Krijf/KICAD_Library/README.md

# KICAD_Library
Personal Library for KICAD
