Krijf/KICAD_Library/Attribute.png

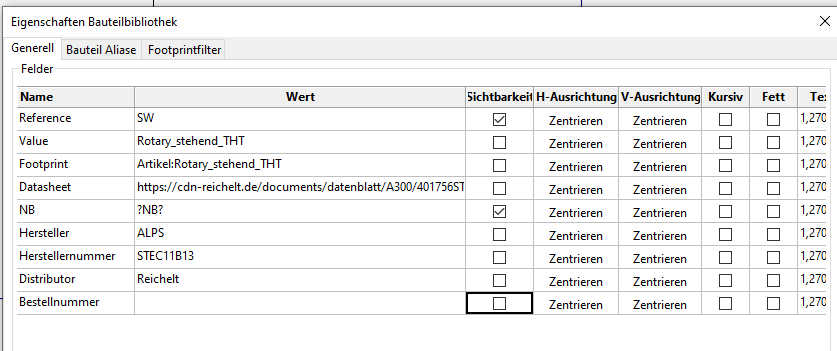
Attribute.png
