Krijf/KICAD_Library/3D_Models/PCB_Switch_Winkel_THT.step

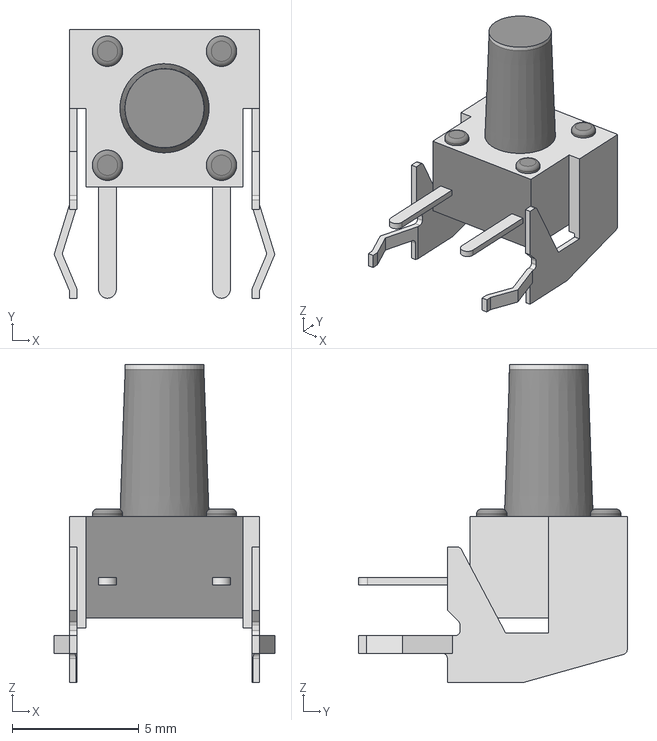
[picture p2: CAD file, 2020-07-17]
3D_Models/PCB_Switch_Winkel_THT.step
8.71 x 10.6 x 12.6 mm
