Krijf/KICAD_Library/3D_Models/USB_C_Buchse_SMD.stp

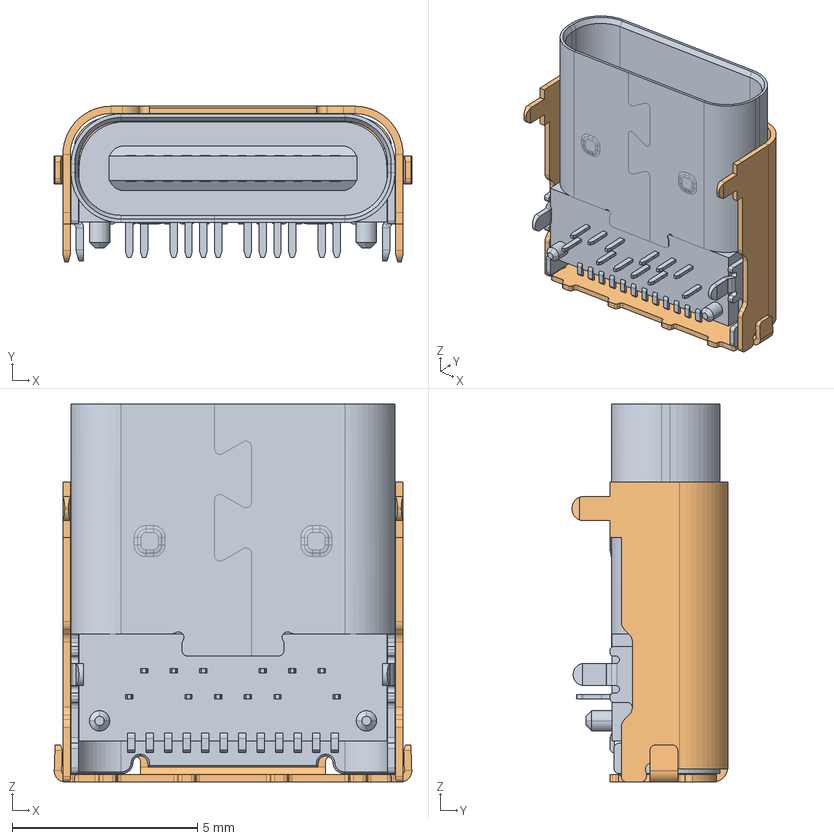
[picture p3: CAD file, 2020-07-17]
3D_Models/USB_C_Buchse_SMD.stp
9.65 x 4.20 x 10.2 mm
