Krijf/KICAD_Library/3D_Models/Rotary_stehend_THT.step

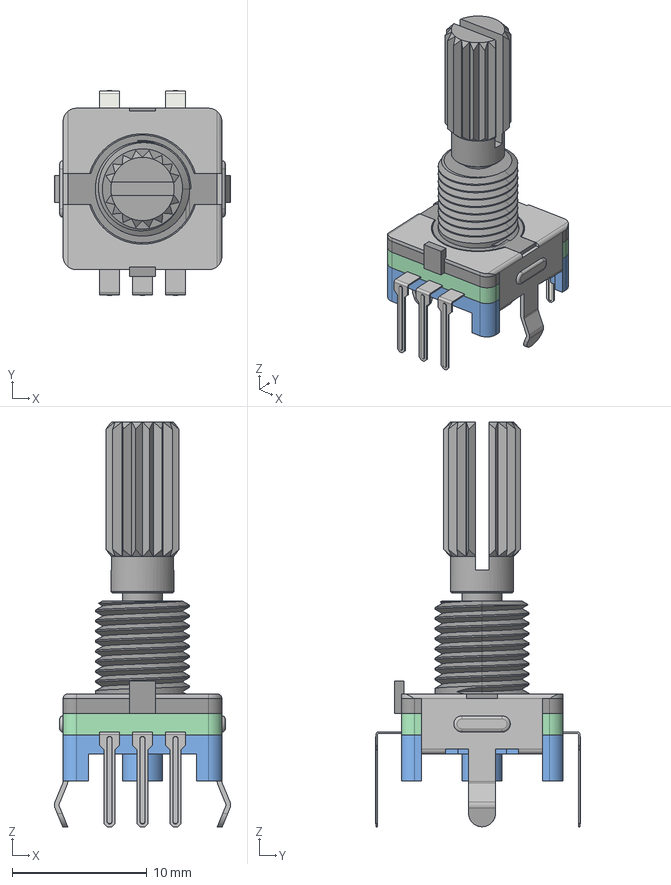
[picture p4: CAD file, 2020-07-16]
3D_Models/Rotary_stehend_THT.step
13.1 x 15.3 x 30.1 mm
