Krijf/KICAD_Library/3D_Models/Neopixel.step

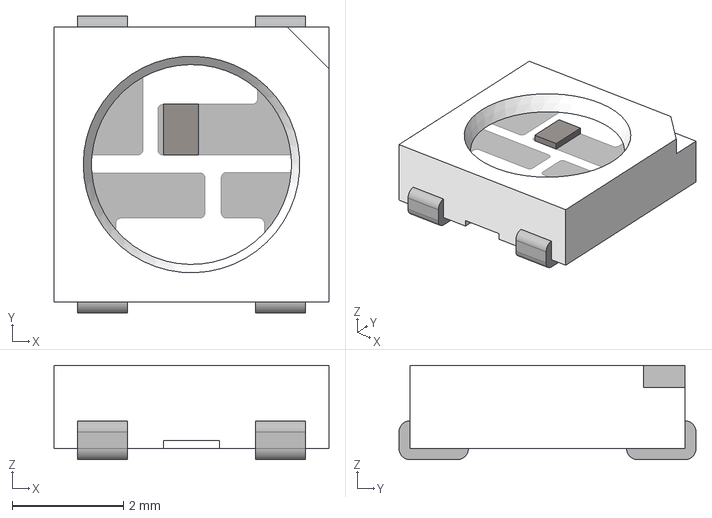
[picture p5: CAD file, 2020-07-16]
3D_Models/Neopixel.step
4.95 x 5.35 x 1.70 mm
