Krijf/KICAD_Library/3D_Models/RESC1608.step

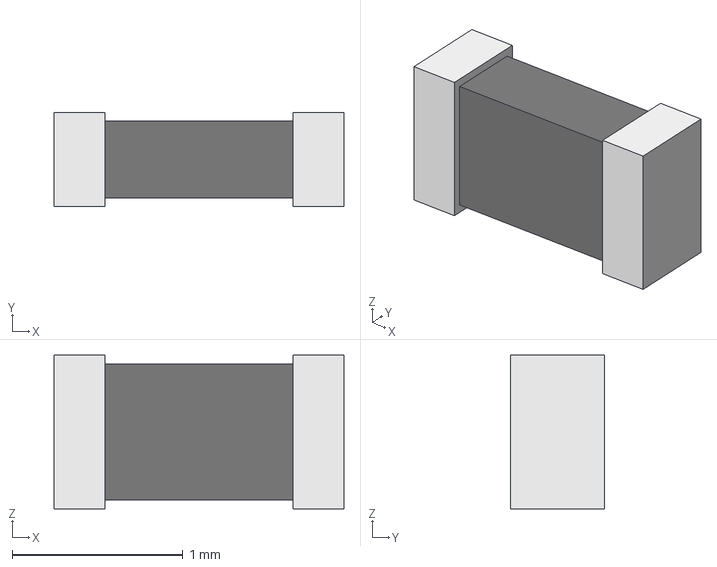
[picture p6: CAD file, 2020-07-06]
3D_Models/RESC1608.step
1.70 x 0.55 x 0.9 mm
