Krijf/KICAD_Library/3D_Models/CAPC3225.step

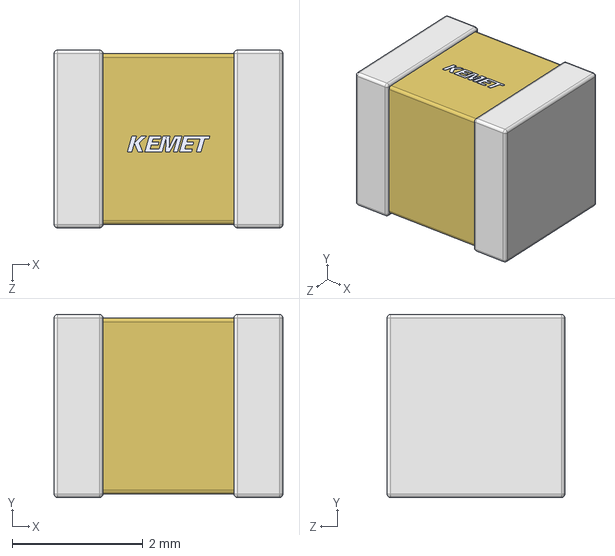
[picture p7: CAD file, 2020-07-06]
3D_Models/CAPC3225.step
3.50 x 2.80 x 2.72 mm
