Krijf/KICAD_Library/3D_Models/ATMEGA32U4-AU.step

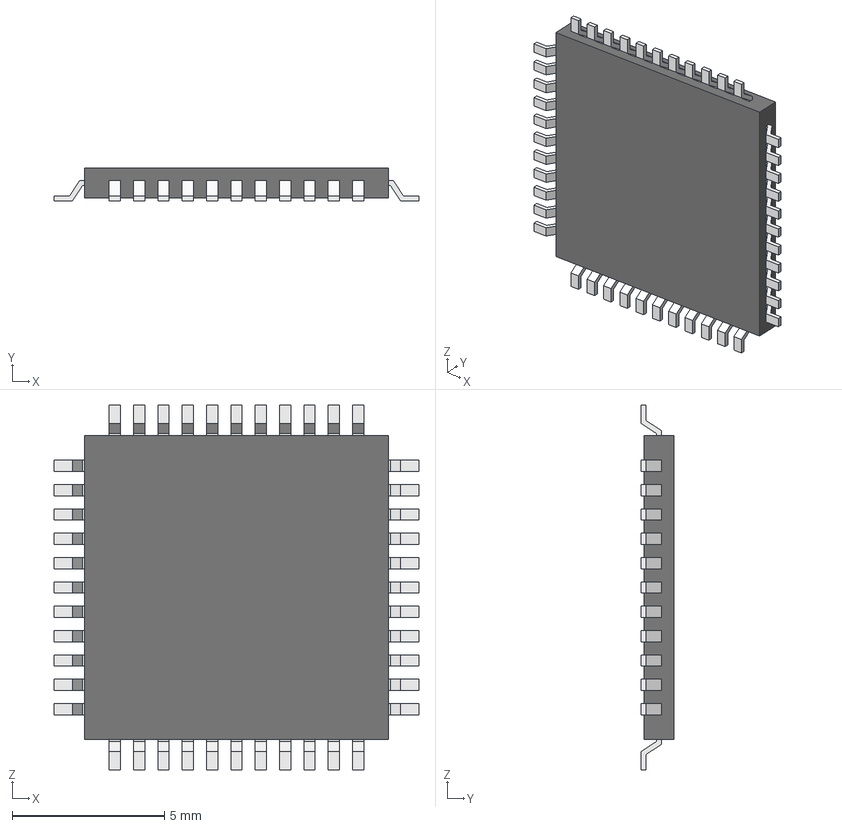
[picture p8: CAD file, 2020-07-06]
3D_Models/ATMEGA32U4-AU.step
12.0 x 1.10 x 12.0 mm
