Krijf/KICAD_Library/3D_Models/CAPC1608.step

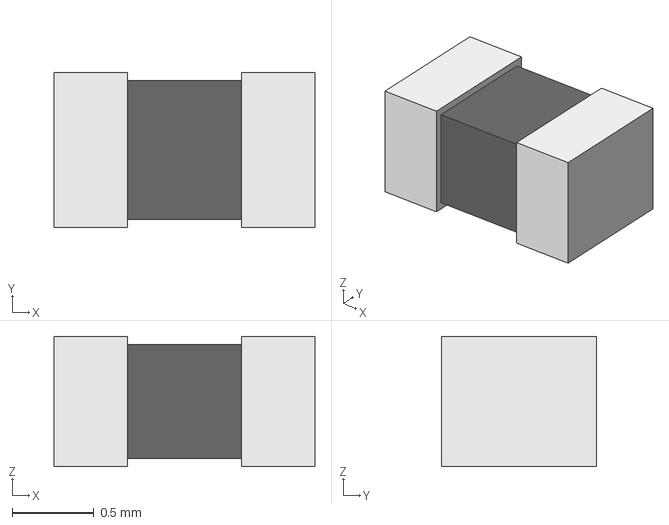
[picture p9: CAD file, 2020-07-06]
3D_Models/CAPC1608.step
1.60 x 0.95 x 0.8 mm
