Krijf/KICAD_Library/(commit log)

2020-07-06 Lib initial in GITHUB erstellt
    [ATMEGA32U4-AU.step, CAPC1608.step, CAPC3225.step, RESC1608.step]
2020-07-08 added Rotary Encoder to shematic lib
2020-07-12 add Footprint Lib Artikel
    add Footprint: ESD_0603;Neopixel; PCB_Switch_Winkel_THT; Rotary_stehend_THT
2020-07-16 Bauteile Aktualiesiert
    TP Pin 1 zugewiesen;
    USB Buchse Typ B Footprint erstellt;
    2x3_254 Footprint erstellt
2020-07-16 3d Files and USB TYPE C Connector
    [Neopixel.step, PCB_Switch_Winkel_THT.step, Rotary_stehend_THT.step, USB_C_Buchse_SMD.STEP]
2020-07-17 Lib pdate
    [USB_C_Buchse_SMD.STEP, USB_C_Buchse_SMD.stp]
2020-07-17 lib updated
    [PCB_Switch_Winkel_THT.step]
2020-08-27 Silkscreen Dicker gemacht
2020-11-04 Bauteilanlage
    - Sicherung 500mA hinzugefügt
    - USB C Buchse verbessert
2020-11-17 T_NFET und Diode hinzugefügt
2020-11-17 Audio & USB Switch hinzugefügt
2020-11-24 SMD 1,27mm Stecker hinzugefügt
